einsua/Escornabot_Pintor_Kit/Conexiones/Conexiones_Kit_Pintor.png

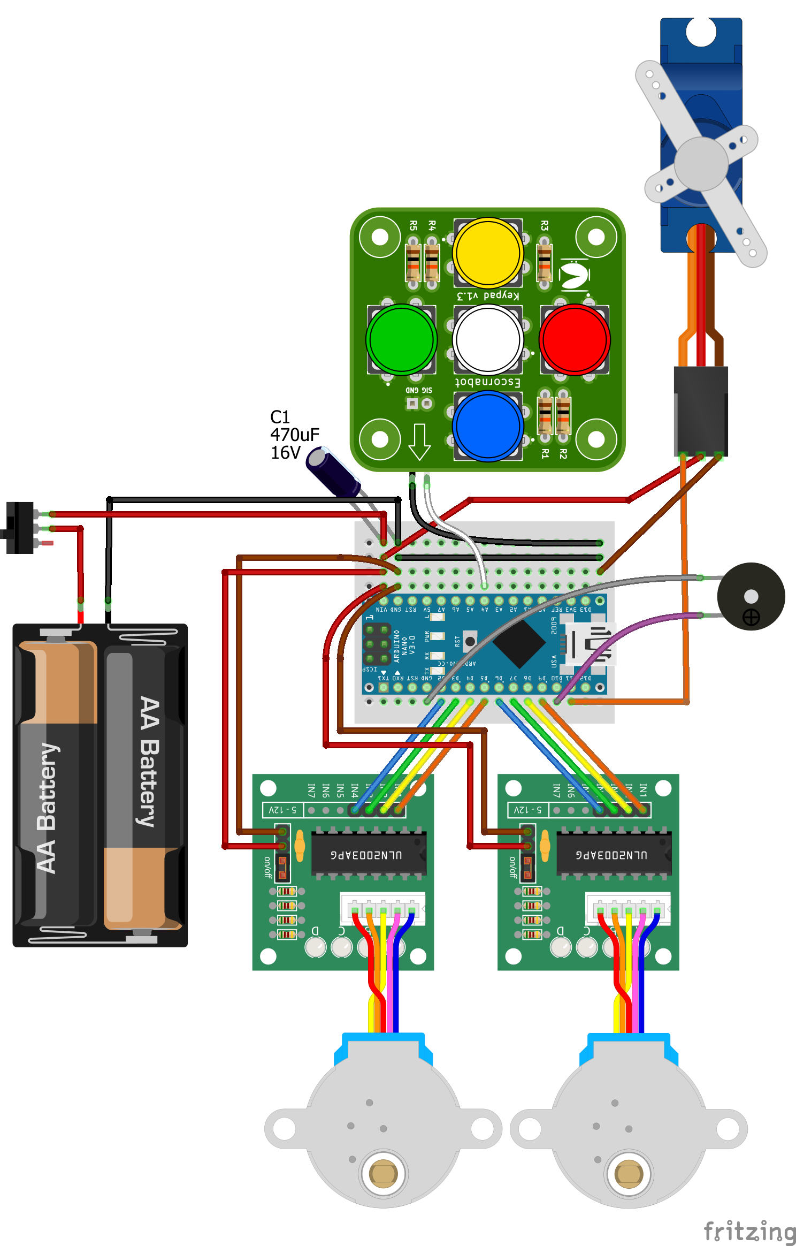
Conexiones/Conexiones_Kit_Pintor.png
