einsua/Escornabot_Pintor_Kit/Código/Escornabot_Pintor_Kit.png

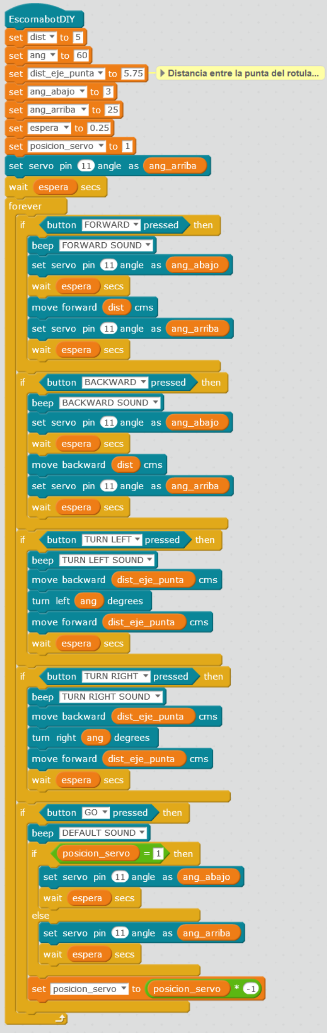
Código/Escornabot_Pintor_Kit.png
