einsua/Escornabot_Pintor_Kit/Código/Escornabot_Pintor_Kit_programable.png

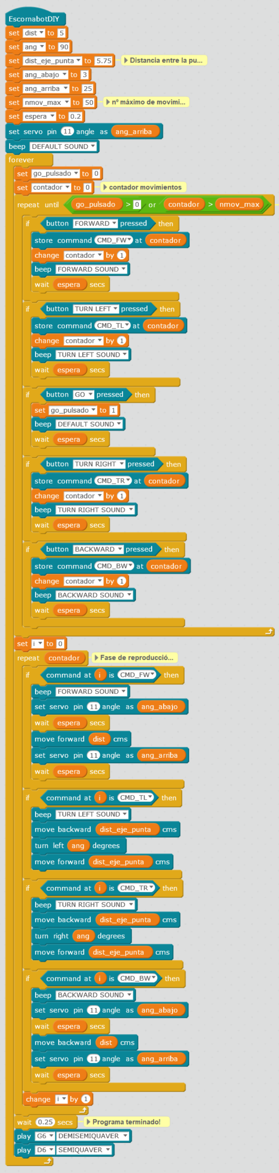
Código/Escornabot_Pintor_Kit_programable.png
