einsua/Escornabot_Pintor_Kit/3D/Escornabot_Pintor_Kit.FCStd

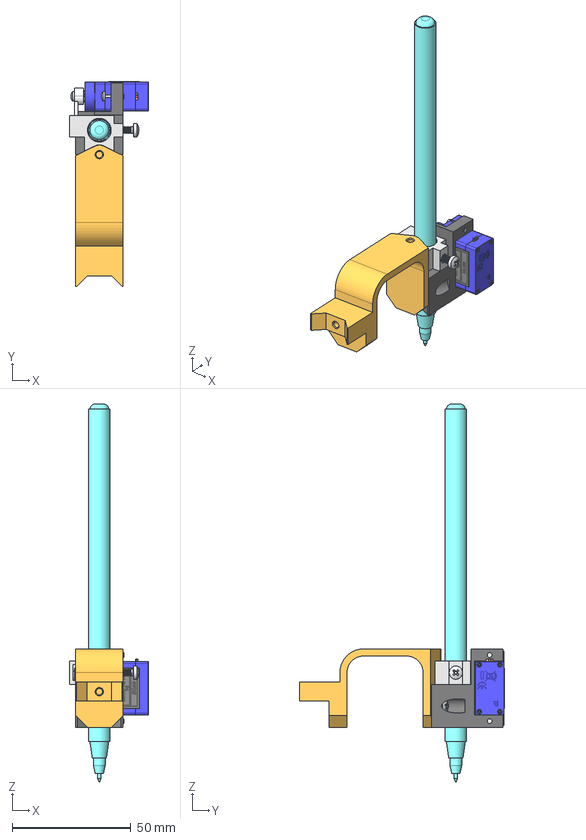
[picture p8: CAD file, 2022-03-13]
3D/Escornabot_Pintor_Kit.FCStd
33.3 x 86.1 x 159.0 mm
Body-main
Body-pen-holder
Body-pen
SG90 - Micro Servo 9g - Tower Pro.1_Pea
SG90 - Micro Servo 9g - Tower Pro.1_Pea001
SG90 - Micro Servo 9g - Tower Pro.1_Pea002
SG90 - Micro Servo 9g - Tower Pro.1_Pea003
SG90 - Micro Servo 9g - Tower Pro.1_Pea004
SG90 - Micro Servo 9g - Tower Pro.1_Pea005
SG90 - Micro Servo 9g - Tower Pro.1_Pea006
SG90 - Micro Servo 9g - Tower Pro.1_Pea007
SG90 - Micro Servo 9g - Tower Pro.1_Pea008
SG90 - Micro Servo 9g - Tower Pro.1_Pea009
SG90 - Micro Servo 9g - Tower Pro.1_Pea010
SG90 - Micro Servo 9g - Tower Pro.1_Pea011
SG90 - Micro Servo 9g - Tower Pro.1_Pea012
SG90 - Micro Servo 9g - Tower Pro.2_Pea
Body-battery-bracket
M3x10-Screw
M3x8-Screw-main-body01
M3x8-Screw-main-body02
M2x8-Screw-servo01
M2x8-Screw-servo02
M2x3-Screw-servo-arm
