einsua/Escornabot_Pintor_Kit/(list of files, drawings)

Other design files:
Conexiones/Conexiones_Kit_Pintor.fzz
