einsua/Escornabot_Pintor_Kit/Código/Test_distancia.gif

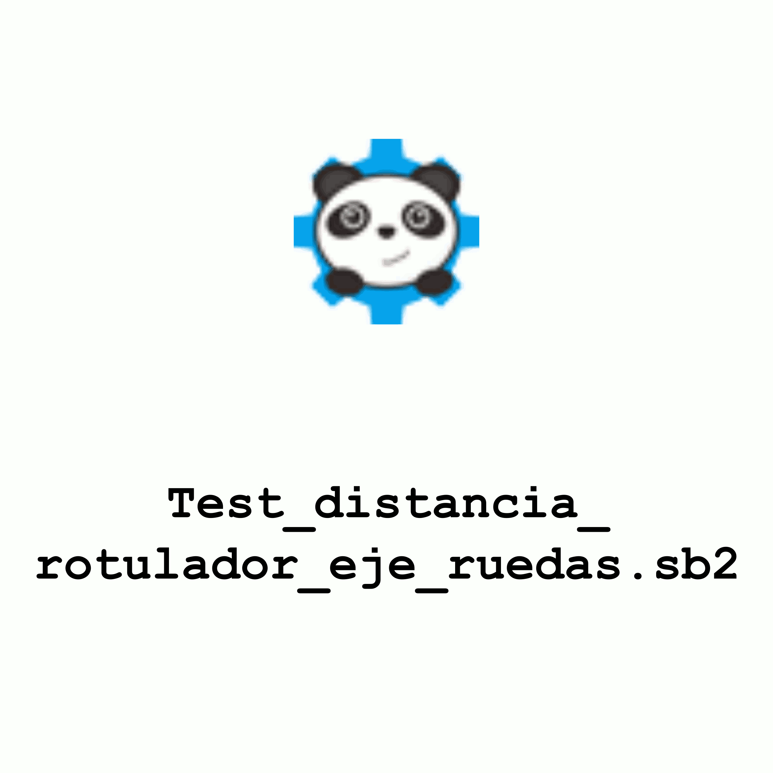
Código/Test_distancia.gif
