einsua/Escornabot_Pintor_Kit/Código/Test_distancia_rotulador_eje_ruedas.png

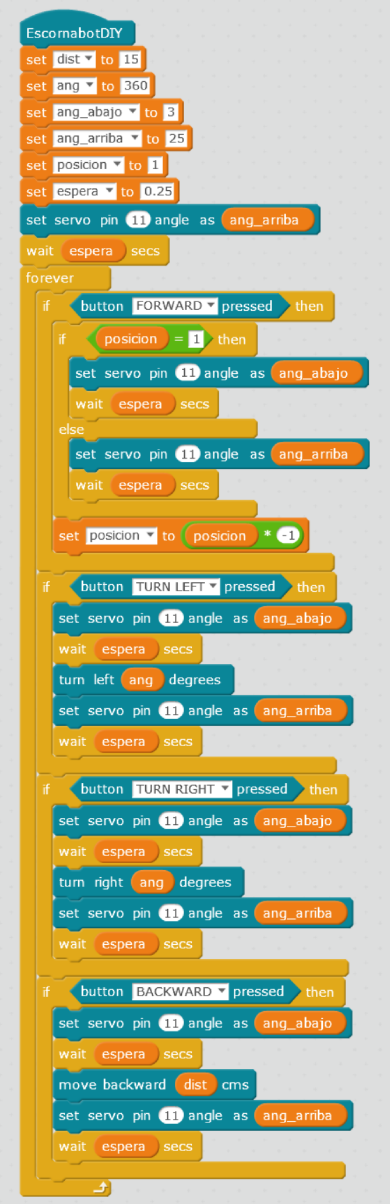
Código/Test_distancia_rotulador_eje_ruedas.png
