einsua/Escornabot_Pintor_Kit/(commit log)

2022-03-13 Initial release
    [Conexiones_Kit_Pintor.fzz, Escornabot_Pintor_Kit.FCStd]
2022-03-31 Actualizados códigos para no depender de la extensión Servo
